timcallinan/AACC-Mobile-Robot1/PHOTOS/PXL_20241031_230812135.jpg

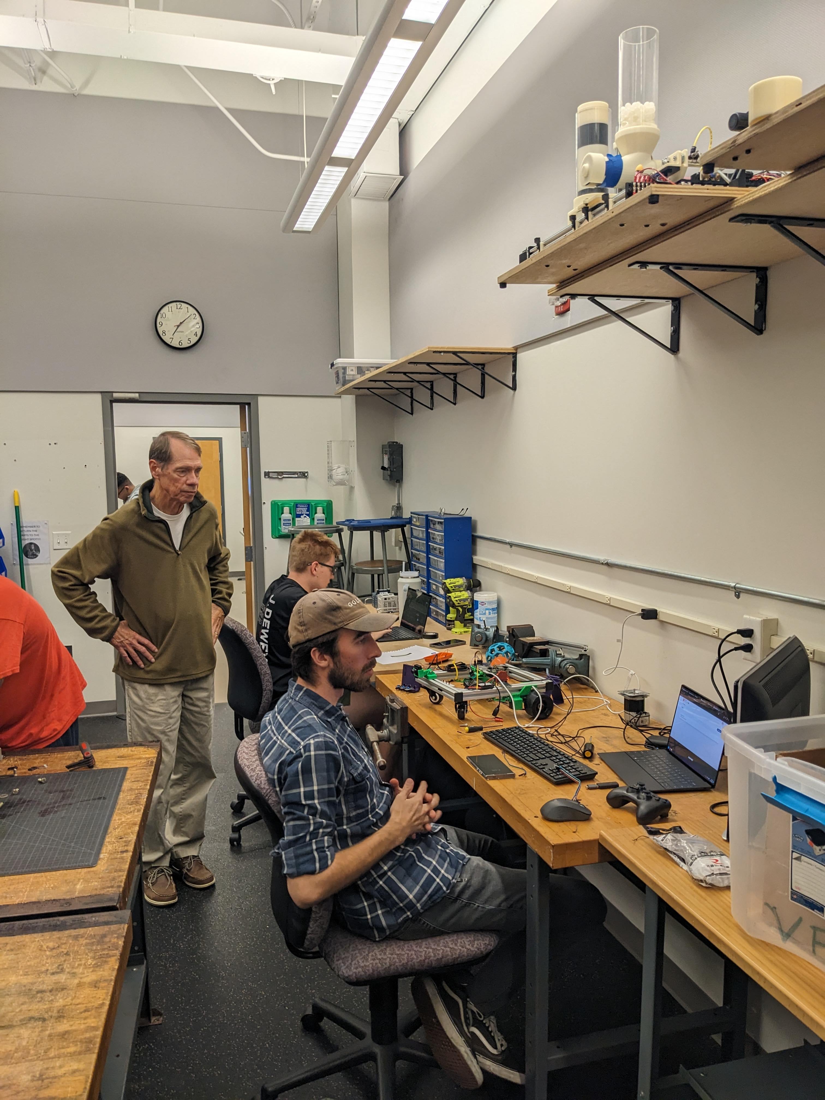
PHOTOS/PXL_20241031_230812135.jpg
