timcallinan/AACC-Mobile-Robot1/PHOTOS/PXL_20241026_181628416.MP.jpg

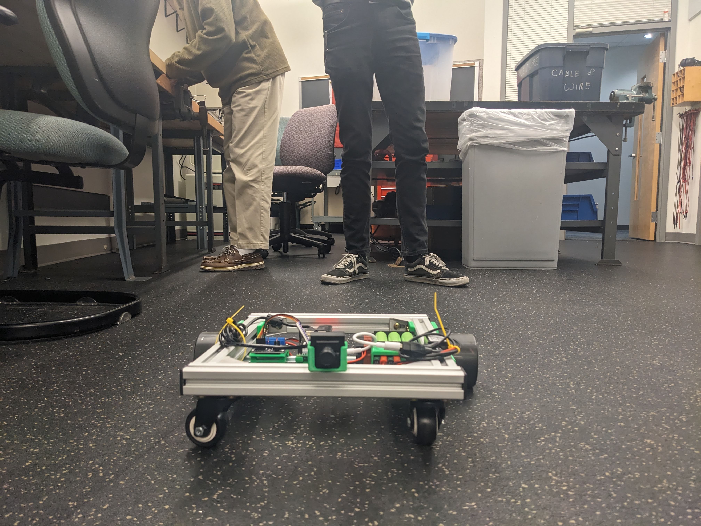
PHOTOS/PXL_20241026_181628416.MP.jpg
