timcallinan/AACC-Mobile-Robot1/Journal_stuff/readme.txt

# Journal of Emerging Scholarship
## Article submitted for publication in Word format.
