timcallinan/AACC-Mobile-Robot1/CODE/readme.txt

Scuttle robot software for robot #1. (we need names for them)

As of 1/25/2025 the code integrates the gamepad for default control,
gamepad right trigger button enables line tracking and
gamepad left trigger button enables colored (orange) ball tracking using openCV.
