timcallinan/AACC-Mobile-Robot1/PHOTOS/PXL_20241031_230824595.jpg

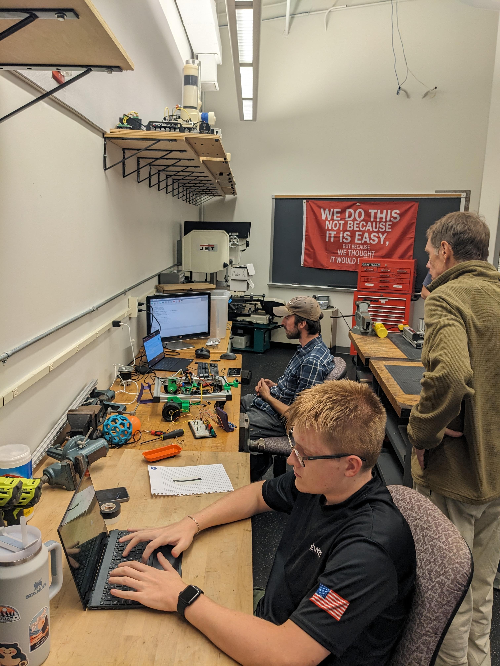
PHOTOS/PXL_20241031_230824595.jpg
