timcallinan/AACC-Mobile-Robot1/BOMs/MICKE PARTS.xlsx

ITEM # | PART# | QUANTITY | PART PRICE | TOTAL COST | DESCRIPTION | LINK
1 | WL-RBT-508 | 2 | 20 | 40 | 5" Robot Wheel w/ 8mm Key Hub | https://www.robotshop.com/products/5-robot-wheel-8mm-key-hub?gad_source=1
2 | BRINGSMART | 2 | 34.15 | 68.3 | 24V 40 RPM Geared Motor w Bracket | https://a.co/d/ilkBZNK
3 | BRACKET1 | 2 | 8.99 | 17.98 | GearMotor Bracket | https://a.co/d/gZDR22Z
4 | 8020RAIL | 2 | 27.99 | 55.98 | 72" 8020 Rail 1"x1" | https://a.co/d/16kECSi
5 | 80203393 | 1 | 27.44 | 27.44 | 8020 Hardware 1/4-20 | https://a.co/d/g0leeVv
6 | RAILBRACKET KIT | 1 | 22.88 | 22.88 | 20Set Bracket with Screw Nut | https://a.co/d/4VyY7WK
7 | ACRYLIC SHEET | 1 | 69.99 | 69.99 | 1/4" Acrylic | https://a.co/d/2G4sMqQ
8 | ESTOP BUTTON | 1 | 9.99 | 9.99 | Baomain Red Sign Emergency Stop | https://a.co/d/bM1V5SU
9 | 78155T61 | 2 | 7.65 | 15.3 | 2.5" Cart-Smart Caster | https://www.mcmaster.com/catalog/131/1673/78155T61
10 | 3D PLA | 4 | 14.79 | 59.16 | SUNLU PLA 3D | https://a.co/d/dVzOKTF
11 | STEPDOWN | 1 | 10.98 | 10.98 | DC 12V 24V to DC 5V | https://a.co/d/4U3cK5A
12 | PI5 | 1 | 119.99 | 119.99 | CanaKit Raspberry Pi 5 Basic Kit | https://a.co/d/6AqBp8C
13 | MOTORDRIVER | 1 | 24.99 | 24.99 | DROK DC Motor Driver 2pcs, L298 | https://a.co/d/5d3cKst
14 | LIDAR | 1 | 99.99 | 99.99 | RPLIDAR A1M8 2D 360 Degree | https://a.co/d/eBsnOCq
TOTAL COST |  |  |  | 642.97
