timcallinan/AACC-Mobile-Robot1/CAD/MickE Front Drive.SLDASM

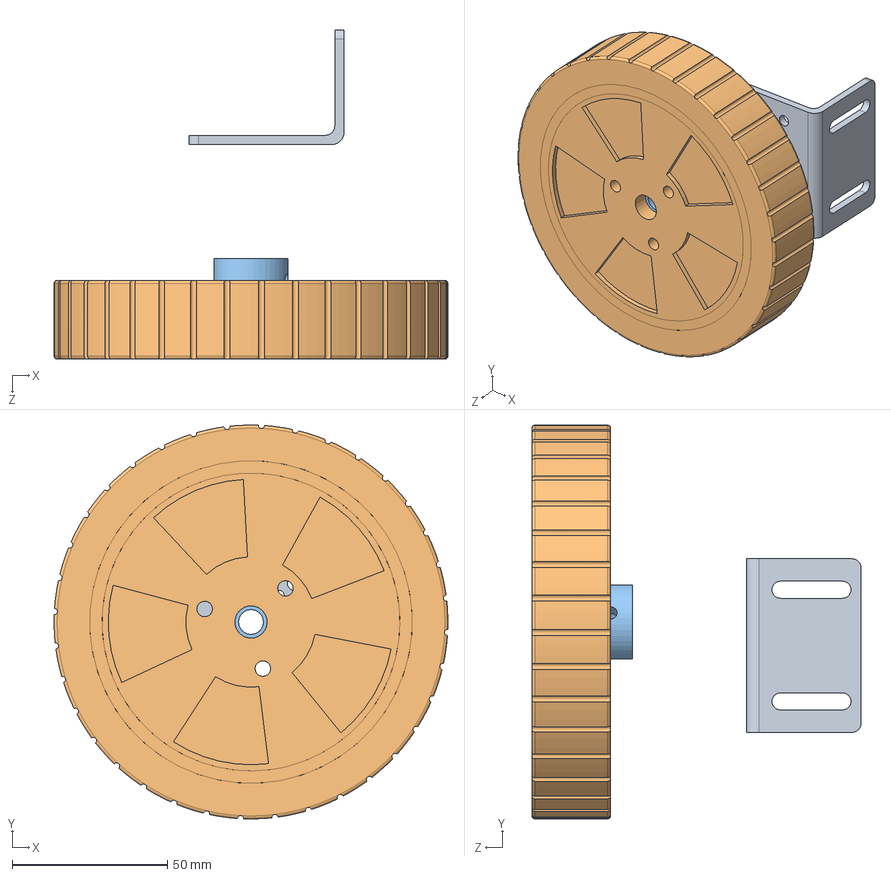
[picture p4: CAD file, 2025-01-12]
CAD/MickE Front Drive.SLDASM
127.0 x 127.0 x 106.1 mm
Cytron 8mm Hub
Cytron 5 Inches Robot Wheel
370 Mounting Bracket
