timcallinan/AACC-Mobile-Robot1/CAD/MickE Frame.SLDASM

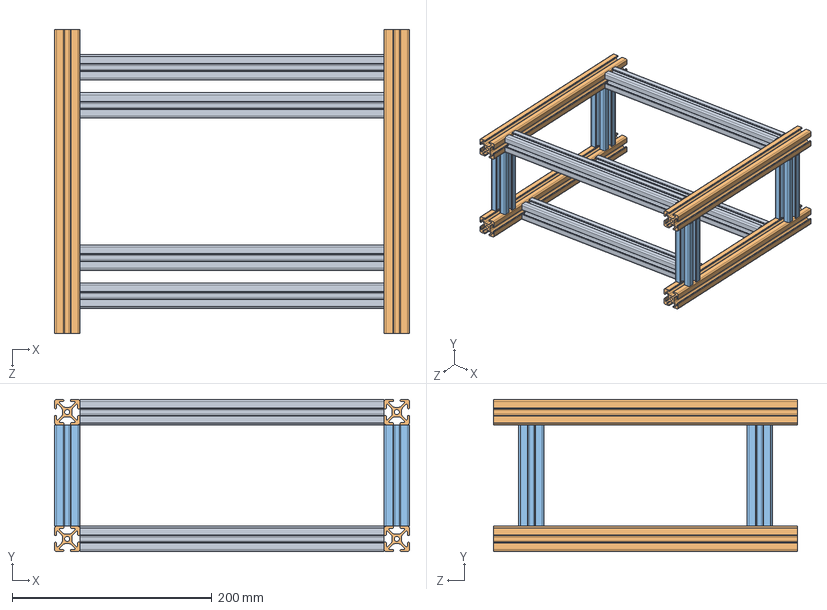
[picture p5: CAD file, 2025-01-12]
CAD/MickE Frame.SLDASM
355.6 x 152.4 x 304.8 mm
1 Inch Extrusion Verticals x 4
1 Inch Extrusion Widths x 4
1 Inch Extrusion Lengths x 4
