timcallinan/AACC-Mobile-Robot1/CAD/1 Inch Extrusion Widths.SLDPRT

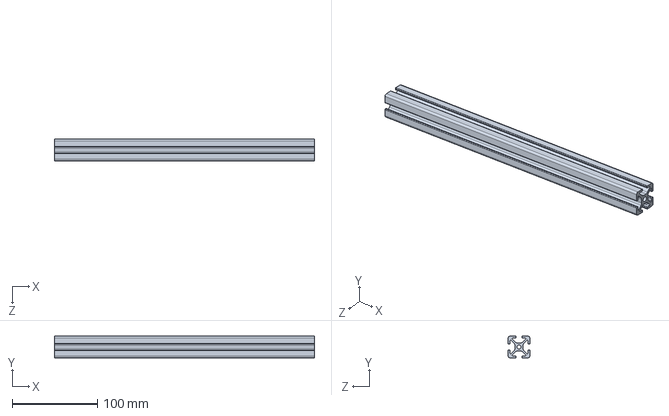
[picture p6: CAD file, 2025-01-12]
CAD/1 Inch Extrusion Widths.SLDPRT
304.8 x 25.4 x 25.4 mm
