timcallinan/AACC-Mobile-Robot1/CAD/Tims Pi5 Case.STEP

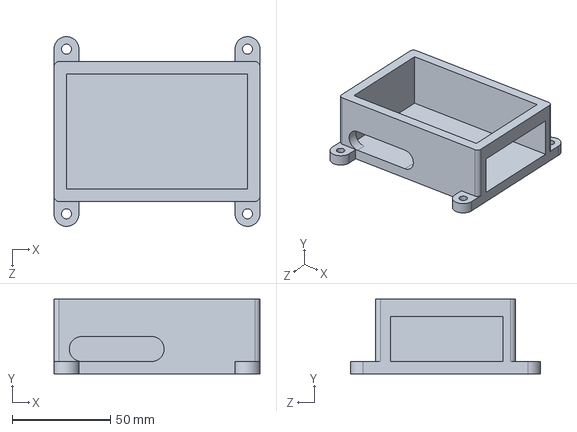
[picture p7: CAD file, 2025-01-12]
CAD/Tims Pi5 Case.STEP
104.8 x 38.1 x 96.5 mm
