timcallinan/AACC-Mobile-Robot1/CAD/Pi5 Case Lid.SLDPRT

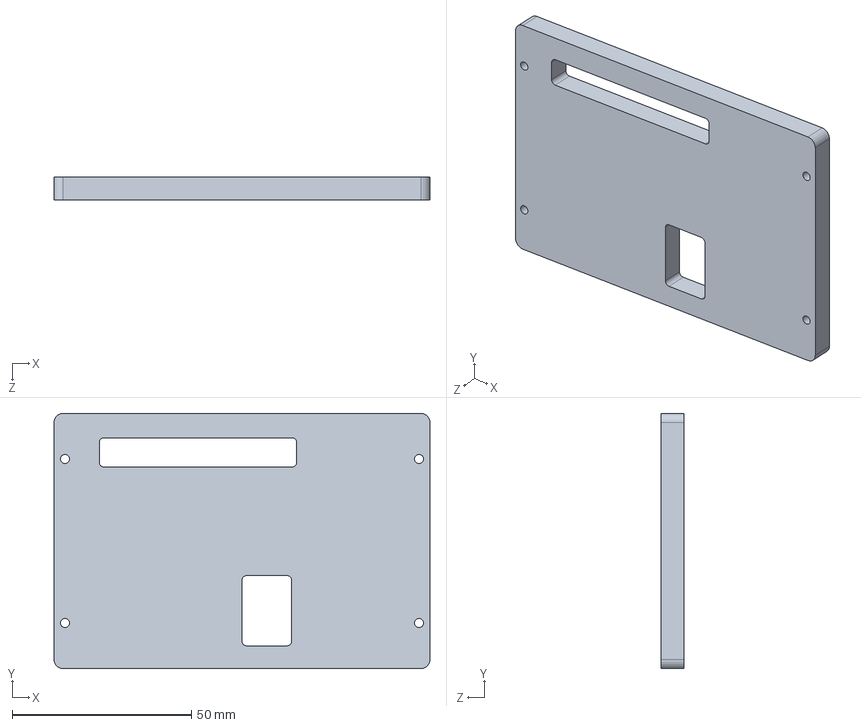
[picture p8: CAD file, 2025-01-12]
CAD/Pi5 Case Lid.SLDPRT
104.8 x 71.1 x 6.35 mm
