timcallinan/AACC-Mobile-Robot1/CAD/370 Mounting Bracket.SLDPRT

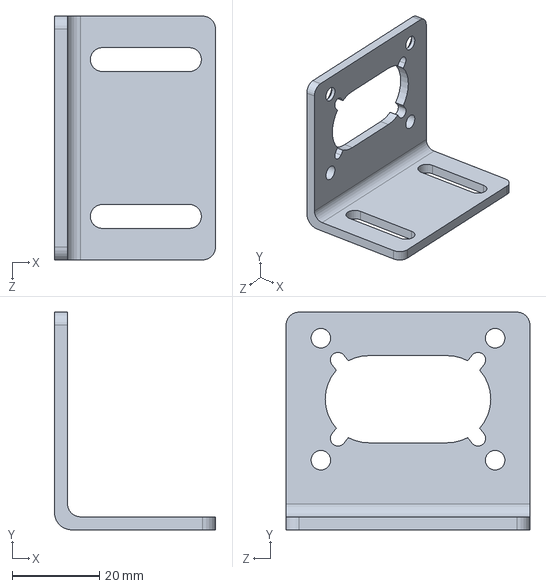
[picture p9: CAD file, 2025-01-12]
CAD/370 Mounting Bracket.SLDPRT
37.0 x 50.0 x 56.0 mm
