timcallinan/AACC-Mobile-Robot1/CAD/1 Inch Extrusion Verticals.SLDPRT

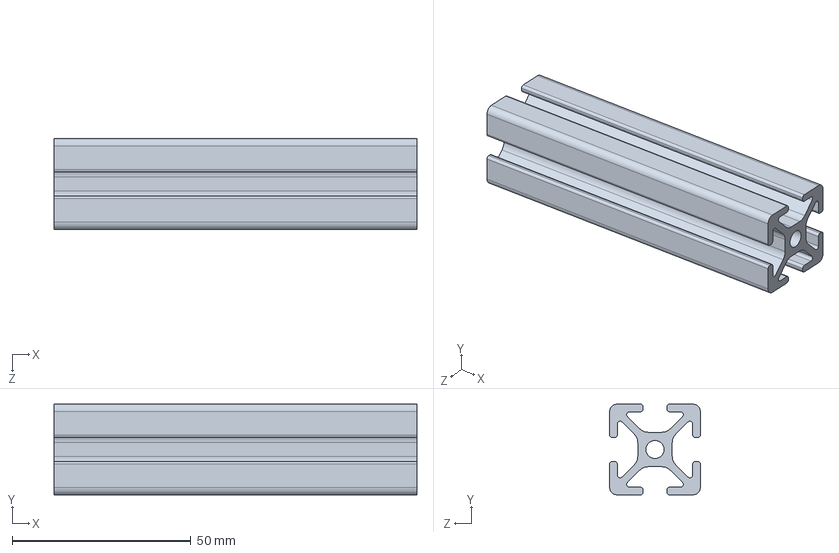
[picture p10: CAD file, 2025-01-12]
CAD/1 Inch Extrusion Verticals.SLDPRT
101.6 x 25.4 x 25.4 mm
