timcallinan/AACC-Mobile-Robot1/CAD/EA60-12.SLDPRT

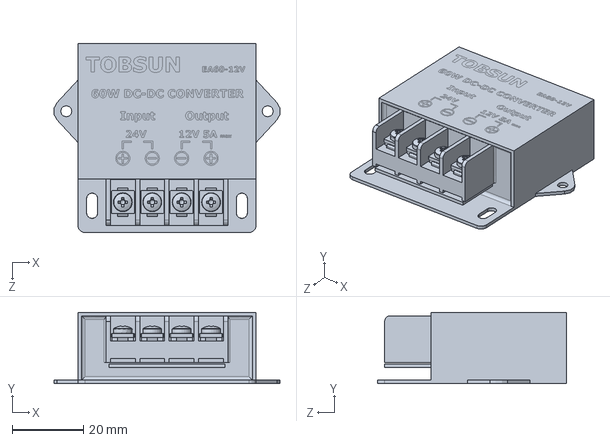
[picture p11: CAD file, 2025-01-12]
CAD/EA60-12.SLDPRT
63.4 x 20.0 x 53.0 mm
