timcallinan/AACC-Mobile-Robot1/CAD/MickE Base Plate.SLDPRT

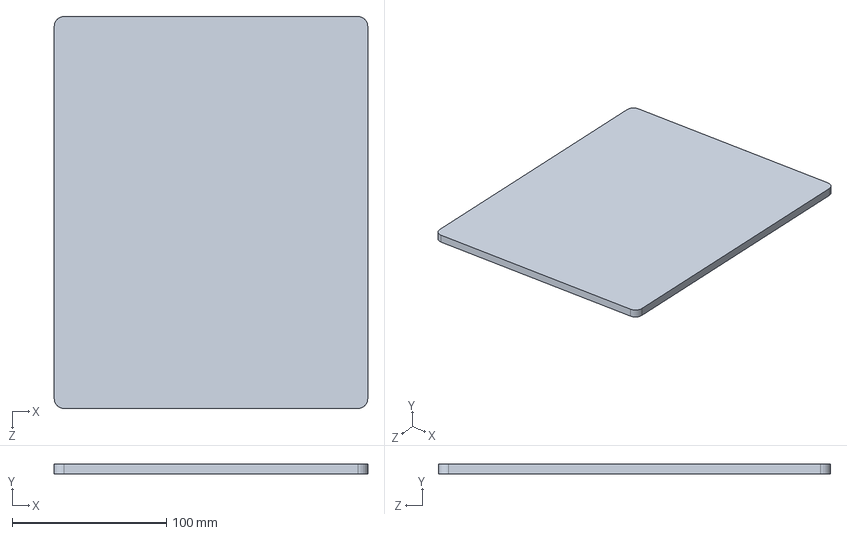
[picture p12: CAD file, 2025-01-12]
CAD/MickE Base Plate.SLDPRT
203.2 x 6.35 x 254.0 mm
