timcallinan/AACC-Mobile-Robot1/CAD/Cytron 5 Inches Robot Wheel.SLDPRT

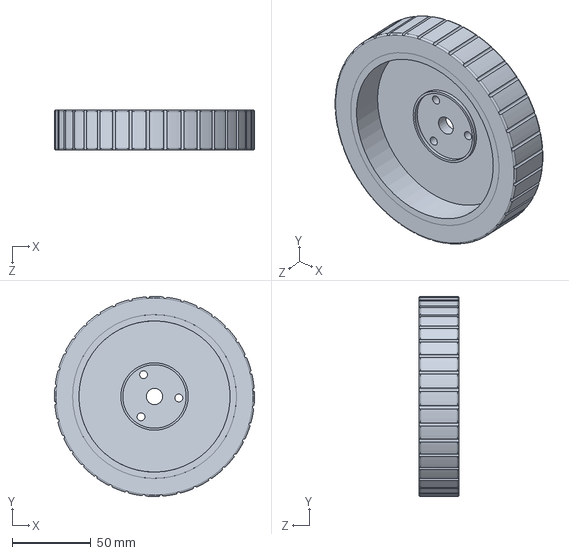
[picture p13: CAD file, 2025-01-12]
CAD/Cytron 5 Inches Robot Wheel.SLDPRT
127.0 x 127.0 x 25.4 mm
