timcallinan/AACC-Mobile-Robot1/CAD/Cytron 8mm Hub.SLDPRT

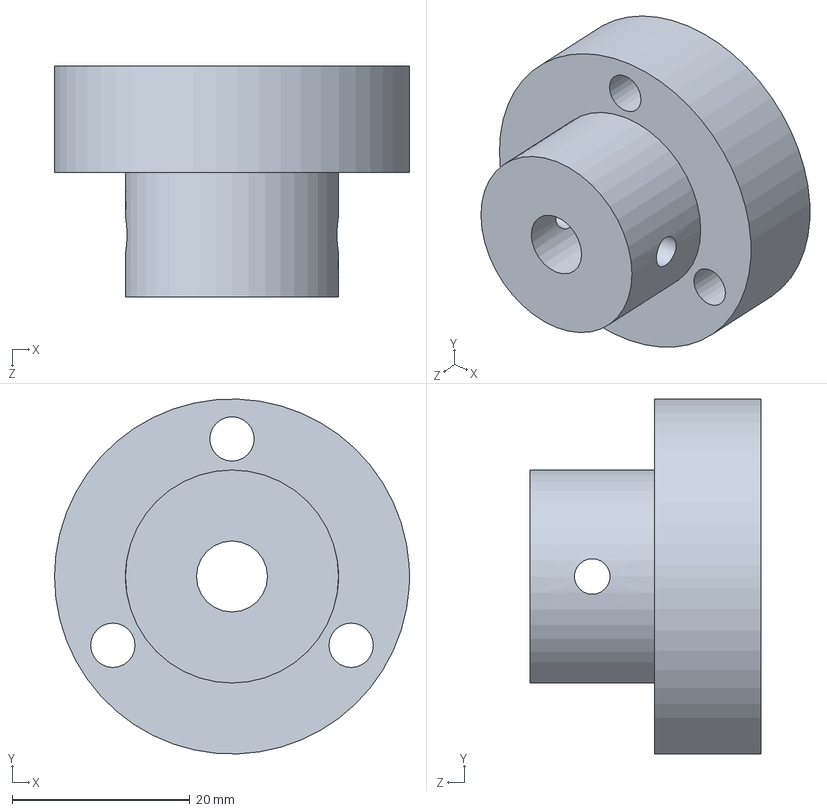
[picture p14: CAD file, 2025-01-12]
CAD/Cytron 8mm Hub.SLDPRT
40.0 x 40.0 x 26.0 mm
