timcallinan/AACC-Mobile-Robot1/CAD/PI5 CASE.SLDASM

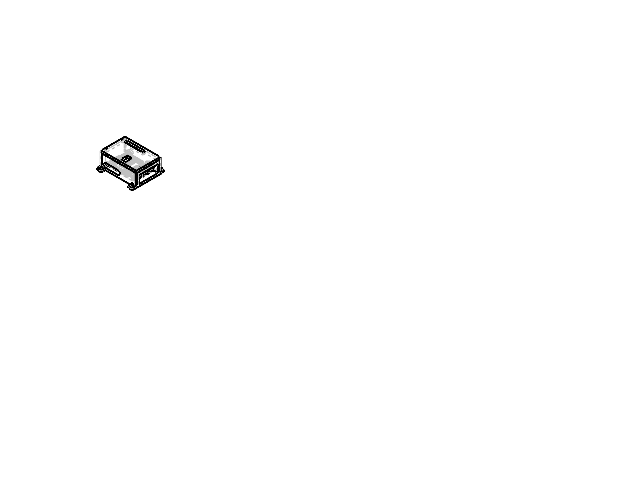
[picture p15: CAD file, 2025-01-12]
CAD/PI5 CASE.SLDASM
Tims Pi5 Case
Pi5 Case Lid
