timcallinan/AACC-Mobile-Robot1/(list of files, cad)

Other CAD files:
CAD/MirrorMickE Front Drive.SLDASM
CAD/Dewalt Battery Hanger share v3.SLDASM
CAD/bringsmart_motor 24V 40RPM.SLDASM
CAD/Mirrorbringsmart_motor 24V 40RPM.SLDASM
CAD/Dewalt battery DCB184 - 18V XR 5Ah.SLDASM
CAD/Mirror78155T61_Cart-Smart Caster.SLDPRT
CAD/MirrorCytron 8mm Hub.SLDPRT
CAD/1 Inch Extrusion Lengths.SLDPRT
CAD/Mirror370 Mounting Bracket.SLDPRT
CAD/MirrorCytron 5 Inches Robot Wheel.SLDPRT
CAD/6785K21_Emergency Stop Enclosed Push-Button Switch.SLDPRT
CAD/78155T61_Cart-Smart Caster.SLDPRT
CAD/Tims Pi5 Case.SLDPRT
