timcallinan/AACC-Mobile-Robot1/(commit log)

2025-01-12 Rename MICKE PARTS.xlsx to BOMs/MICKE PARTS.xlsx
    [MICKE PARTS.xlsx]
2025-01-25 Update README.md
    Update Robot 1 TODO list to add web page control/status page and add the IMU for tracking navigation.
